danielkm-ee/EPL-Powercore-V3/CAD/PCV3-enclosure-revF.step

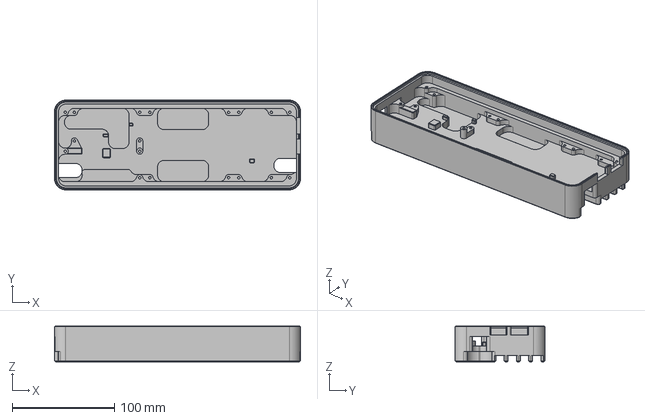
[picture p1: CAD file, 2025-09-30]
CAD/PCV3-enclosure-revF.step
241.0 x 88.0 x 35.0 mm
