danielkm-ee/EPL-Powercore-V3/CAD/PCV3-cover-panel-revF.step

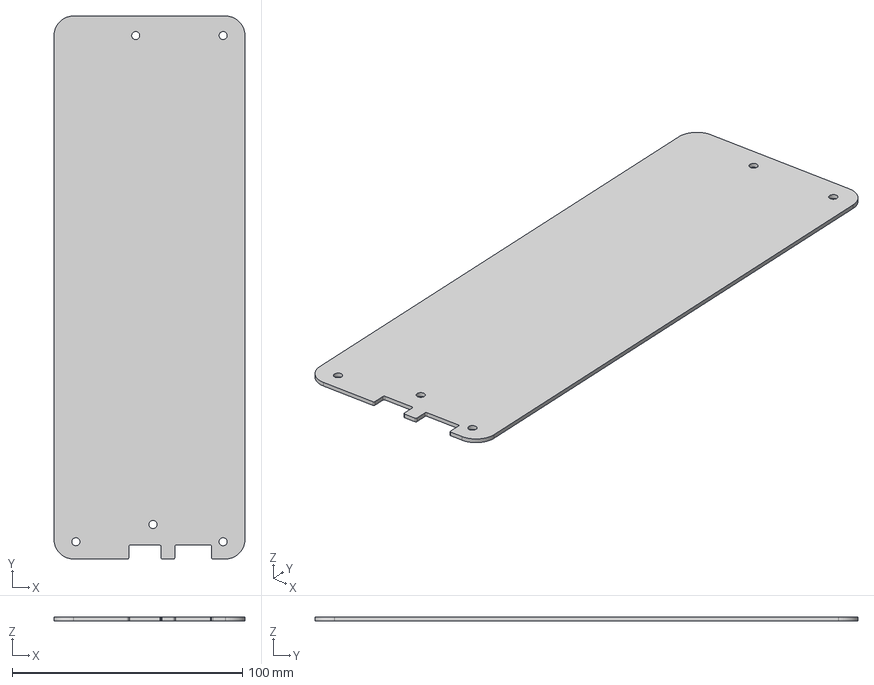
[picture p2: CAD file, 2025-09-30]
CAD/PCV3-cover-panel-revF.step
83.0 x 236.0 x 1.60 mm
