danielkm-ee/EPL-Powercore-V3/circuit-boards/dual-converter-boost-converter-module-V1.0/dual-converter-boost-converter-module-V1.0.kicad_pcb

## KiCad design circuit-boards/dual-converter-boost-converter-module-V1.0/dual-converter-boost-converter-module-V1.0.kicad_pcb (2026-02-24)

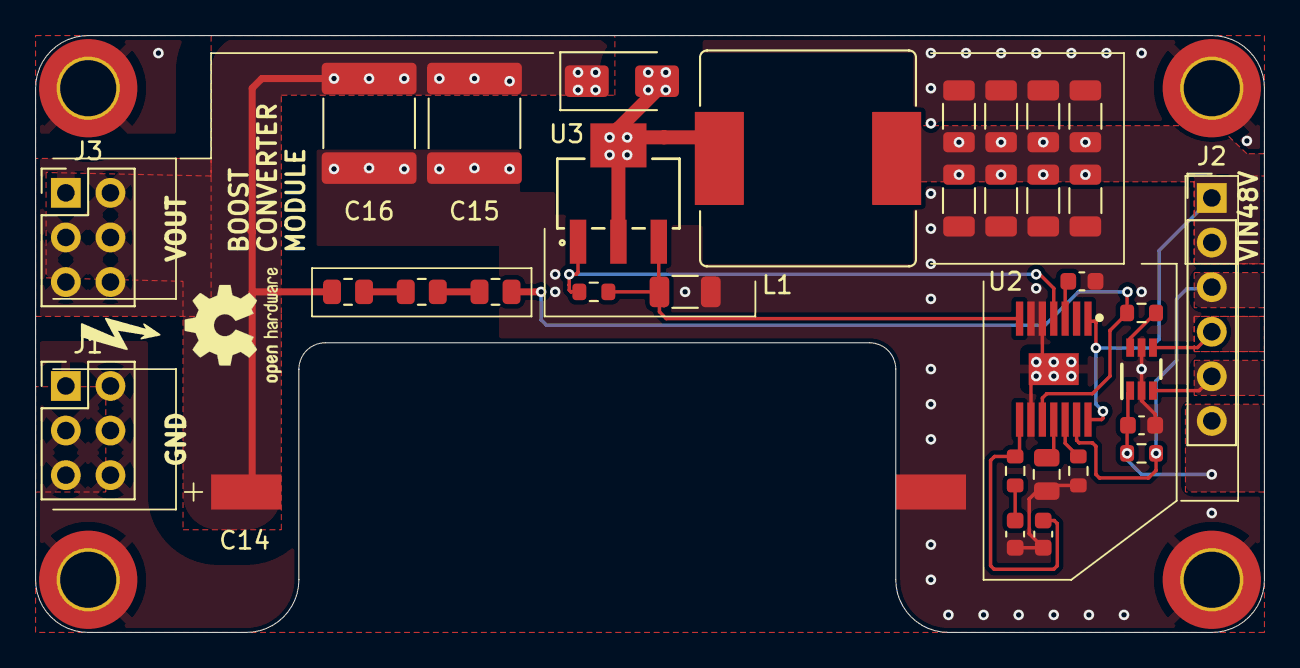
[picture p5: board dual-converter-boost-converter-module-V1.0.kicad_pcb from above]

Board: 4 copper layers, 70.0 x 34.0 mm, 37 parts (0 on the bottom side), 19 nets.

Parts:
C1, C2, C3, C4, C6, C7, C8, C9: 10 uF; C_1206_3216Metric
C5, C10: 1 uF; C_0603_1608Metric
C11: 33 uF; C_0805_2012Metric
C12: 39nF; C_0603_1608Metric
C13: F; C_0603_1608Metric
C14: 22UF; 226TTA350M
C15, C16: 2.2 uF; C_2220_5750Metric
D1: US1M-13-F; D_SMA
H1, H2, H3, H4: M3_DIN; MountingHole_3.2mm_M3_DIN965_Pad_TopBottom
J1, J3: Vout Conn; PinHeader_2x03_P2.54mm_Vertical
J2: Conn_01x06; PinHeader_1x06_P2.54mm_Vertical
L1: 680 uH; SRR1210-681M
R1, R2, R3: 200K; R_0805_2012Metric
R4, R5: 2.2K; R_0603_1608Metric
R6: 49.3K; R_0603_1608Metric
R7: 15K; R_0603_1608Metric
R8: 100K; R_0603_1608Metric
R9: 90mR; R_1206_3216Metric
U1: TPL0401B-10DCKR
U2: LM5156HPWPR; lm5156h
U3: STN3N40K3

Connections:
+3.3V: C5.1, J2.6, R5.1, U1.1 (VDD)
+48V: C1.1, C2.1, C3.1, C4.1, C6.1, C7.1, C8.1, C9.1, J2.1, J2.2, L1.1, U2.1 (BIAS), U2.14 (EN_UVLO_SYNC)
/BOOST_PGOOD: J2.3, R5.2, U2.13 (PGOOD)
/BOOST_SWITCH_NET: D1.2 (A), L1.2, U3.2 (D), U3.4 (D)
/COMPENSATION: C13.1, R7.1, U2.8 (COMP)
/COUT_BOOST: C14.1, C15.1, C16.1, D1.1 (K), J3.1, J3.2, J3.3, J3.4, J3.5, J3.6, R1.1
/CURRENT_SENSE: R8.2, R9.1, U2.7 (CS), U3.3 (S)
/GATE_NET: R8.1, U2.4 (GATE), U3.1 (G)
/V_FEEDBACK: R3.2, R4.2, U2.10 (FB)
GND: C1.2, C2.2, C3.2, C4.2, C5.2, C6.2, C7.2, C8.2, C9.2, C10.2, C11.2, C12.2, C13.2, C14.2, C15.2, C16.2, H1.1, H2.1, H3.1, H4.1, J1.1, J1.2, J1.3, J1.4, J1.5, J1.6, R6.2, R9.2, U1.2 (GND), U1.5 (W), U2.5 (PGND), U2.6 (AGND), U2.9 (DITHOFF), U2.15 (EP)
unnamed: C12.1, R7.2
unnamed: J2.4, U1.4 (SDA)
unnamed: J2.5, U1.3 (SCL)
unnamed: R1.2, R2.1
unnamed: R2.2, R3.1
unnamed: R4.1, U1.6 (H)
unnamed: R6.1, U2.12 (RT)
unnamed: C11.1, U2.11 (SS)
unnamed: C10.1, U2.3 (VCC)
