danielkm-ee/EPL-Powercore-V3/circuit-boards/dual-converter-pi-filter-module-V1.0/dual-converter-pi-filter-module-V1.0.kicad_pcb

## KiCad design circuit-boards/dual-converter-pi-filter-module-V1.0/dual-converter-pi-filter-module-V1.0.kicad_pcb (2026-02-24)

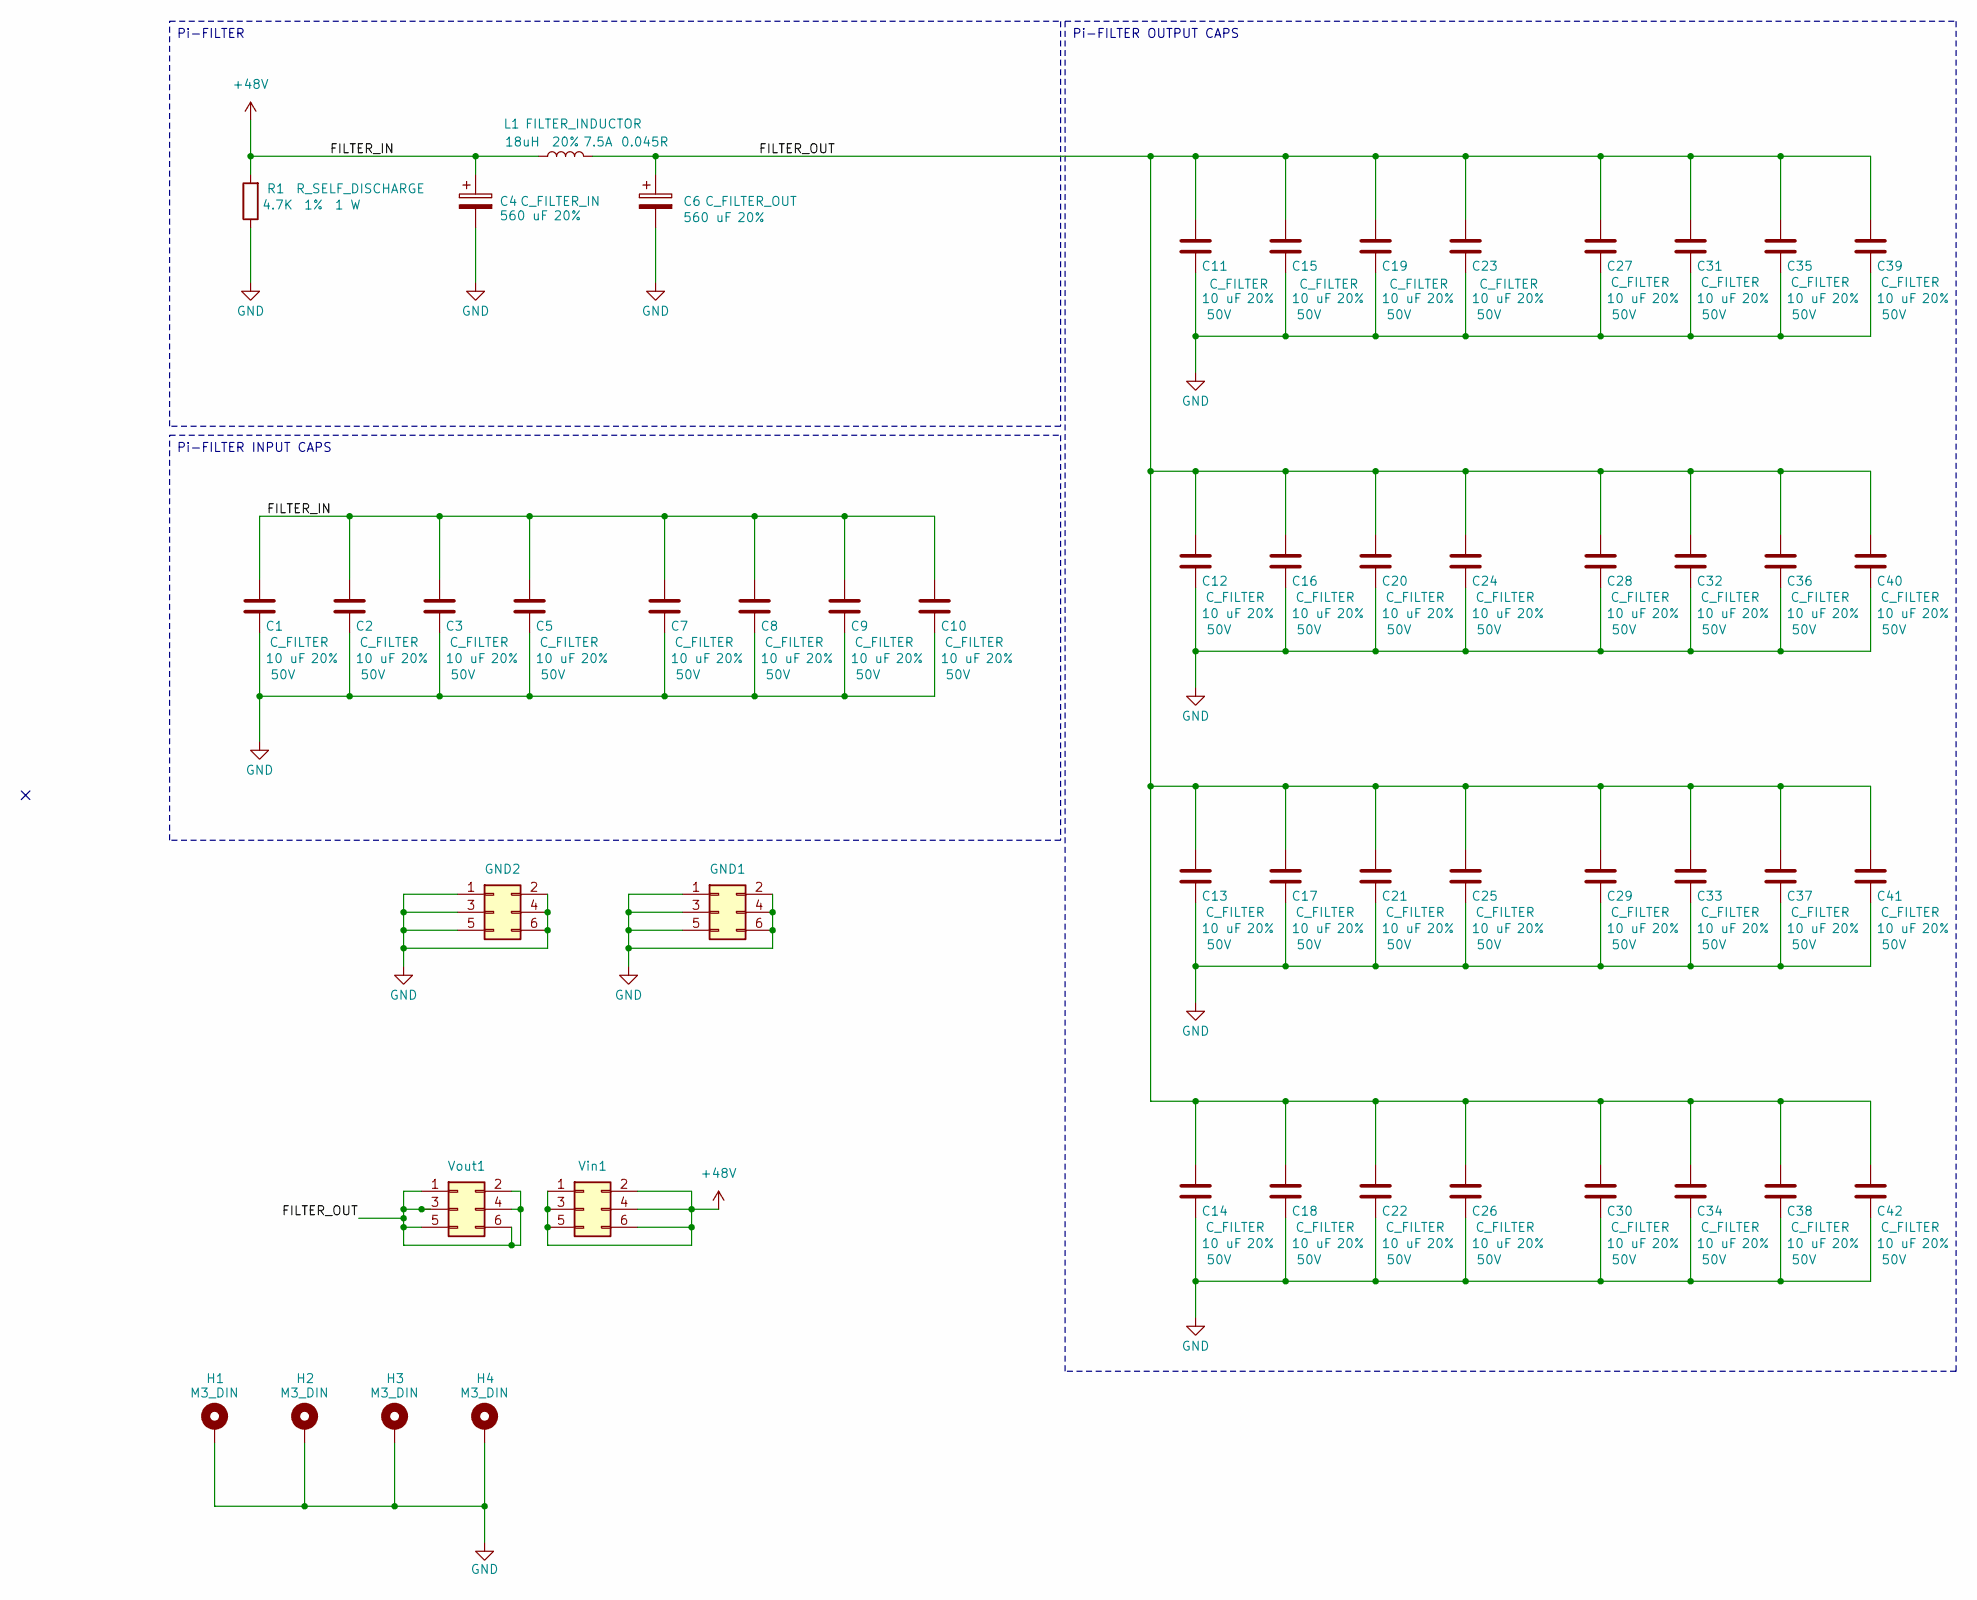
[picture p6: schematic dual-converter-pi-filter-module-V1.0.kicad_sch, dual-converter-pi-filter-module]

Parts:
C1, C2, C3, C5, C7, C8, C9, C10, C11, C12, C13, C14, C15, C16, C17, C18, C19, C20, C21, C22, C23, C24, C25, C26, C27, C28, C29, C30, C31, C32, C33, C34, C35, C36, C37, C38, C39, C40, C41, C42: 10 uF; C_1206_3216Metric; Tolerance 20%; Max Voltage 50V; Manufacturer# CL31A106MBHNNNE; LCSC Part # C96600
C4, C6: 560 uF; PHA225; Tolerance 20%; Manufacturer# PHA225MLP3560QE4; LCSC Part # C3274794
GND1, GND2: Conn_02x03_Odd_Even; PinHeader_2x03_P2.54mm_Vertical
H1, H2, H3, H4: M3_DIN; MountingHole_3.2mm_M3_DIN965_Pad_TopBottom; Manufacturer# NULL
L1: 18uH; SRP1245A; Tolerance 20%; Current Rating 7.5A; Manufacturer# SRP1245A-180M; LCSC Part # C5926042
R1: 4.7K; R_2512_6332Metric; Tolerance 1%; Manufacturer# RC2512JK-074K7L; LCSC Part # C878291
Vin1: Conn_02x03_Odd_Even; PinHeader_2x03_P2.54mm_Vertical
Vout1: Conn_02x03_Odd_Even; PinHeader_2x03_P2.54mm_Vertical

Connections:
+48V: C1.1, C2.1, C3.1, C4.1, C5.1, C7.1, C8.1, C9.1, C10.1, L1.1, R1.2, Vin1.1, Vin1.2, Vin1.3, Vin1.4, Vin1.5, Vin1.6
/FILTER_OUT: C6.1, C11.1, C12.1, C13.1, C14.1, C15.1, C16.1, C17.1, C18.1, C19.1, C20.1, C21.1, C22.1, C23.1, C24.1, C25.1, C26.1, C27.1, C28.1, C29.1, C30.1, C31.1, C32.1, C33.1, C34.1, C35.1, C36.1, C37.1, C38.1, C39.1, C40.1, C41.1, C42.1, L1.2, Vout1.1, Vout1.2, Vout1.3, Vout1.4, Vout1.5, Vout1.6
GND: C1.2, C2.2, C3.2, C4.2, C5.2, C6.2, C7.2, C8.2, C9.2, C10.2, C11.2, C12.2, C13.2, C14.2, C15.2, C16.2, C17.2, C18.2, C19.2, C20.2, C21.2, C22.2, C23.2, C24.2, C25.2, C26.2, C27.2, C28.2, C29.2, C30.2, C31.2, C32.2, C33.2, C34.2, C35.2, C36.2, C37.2, C38.2, C39.2, C40.2, C41.2, C42.2, GND1.1, GND1.2, GND1.3, GND1.4, GND1.5, GND1.6, GND2.1, GND2.2, GND2.3, GND2.4, GND2.5, GND2.6, H1.1, H2.1, H3.1, H4.1, R1.1

Notes on the sheet:
Pi-FILTER INPUT CAPS
Pi-FILTER
Pi-FILTER OUTPUT CAPS

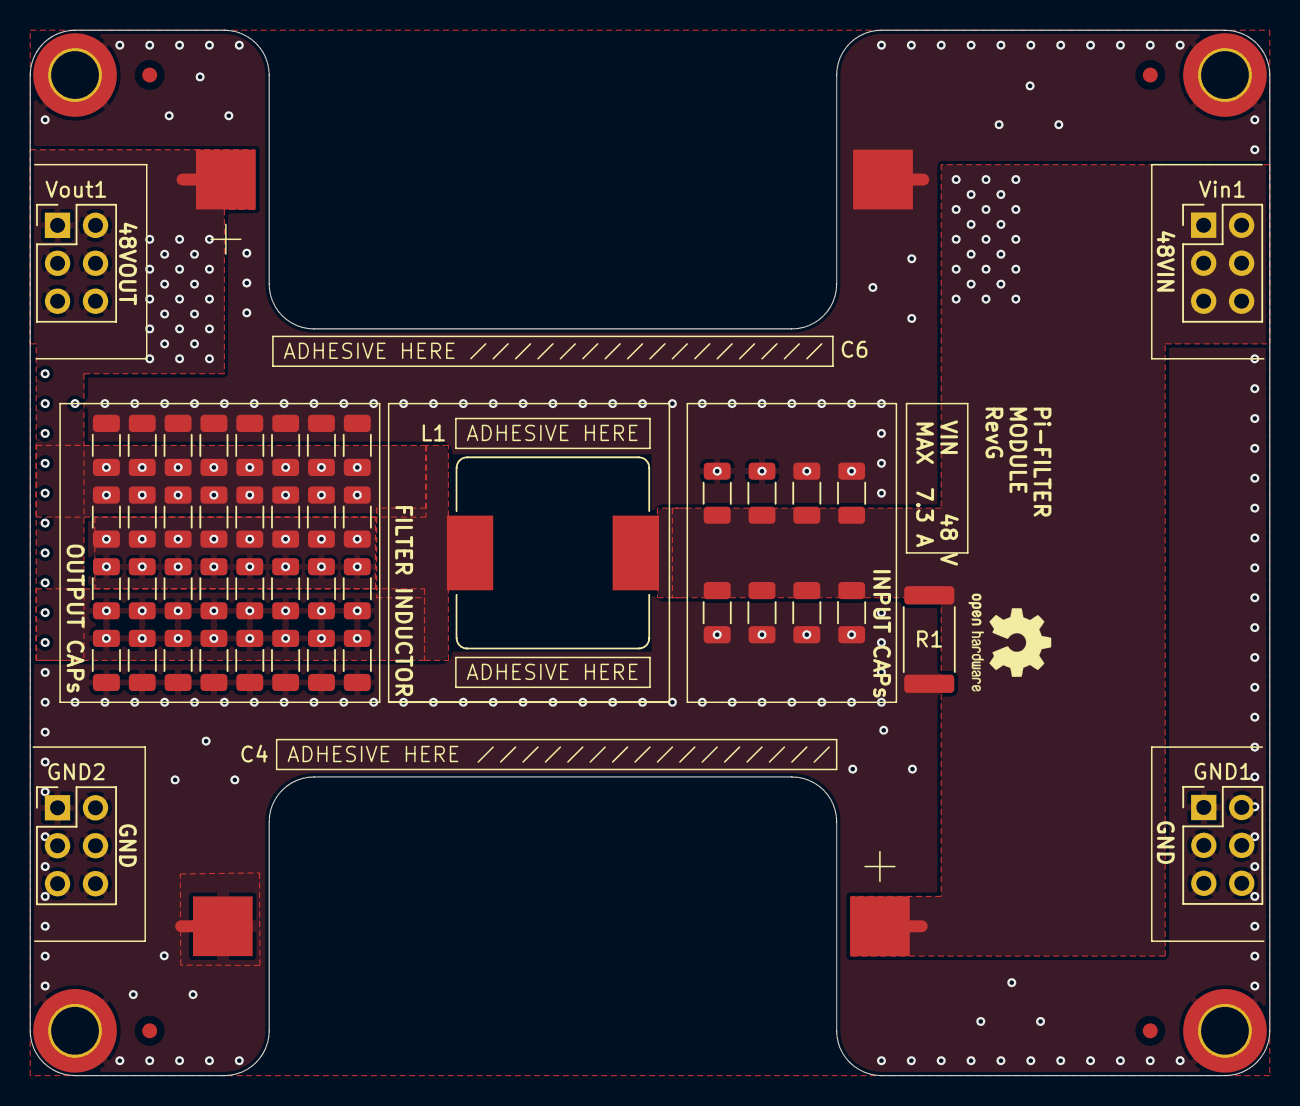
[picture p7: board dual-converter-pi-filter-module-V1.0.kicad_pcb from above]

Board: 4 copper layers, 83.0 x 70.0 mm, 52 parts (0 on the bottom side), 3 nets.
