danielkm-ee/EPL-Powercore-V3/circuit-boards/dual-converter-power-management-module-V1.0/dual-converter-power-management-module-V1.0.kicad_pcb

## KiCad design circuit-boards/dual-converter-power-management-module-V1.0/dual-converter-power-management-module-V1.0.kicad_pcb (2026-02-24)

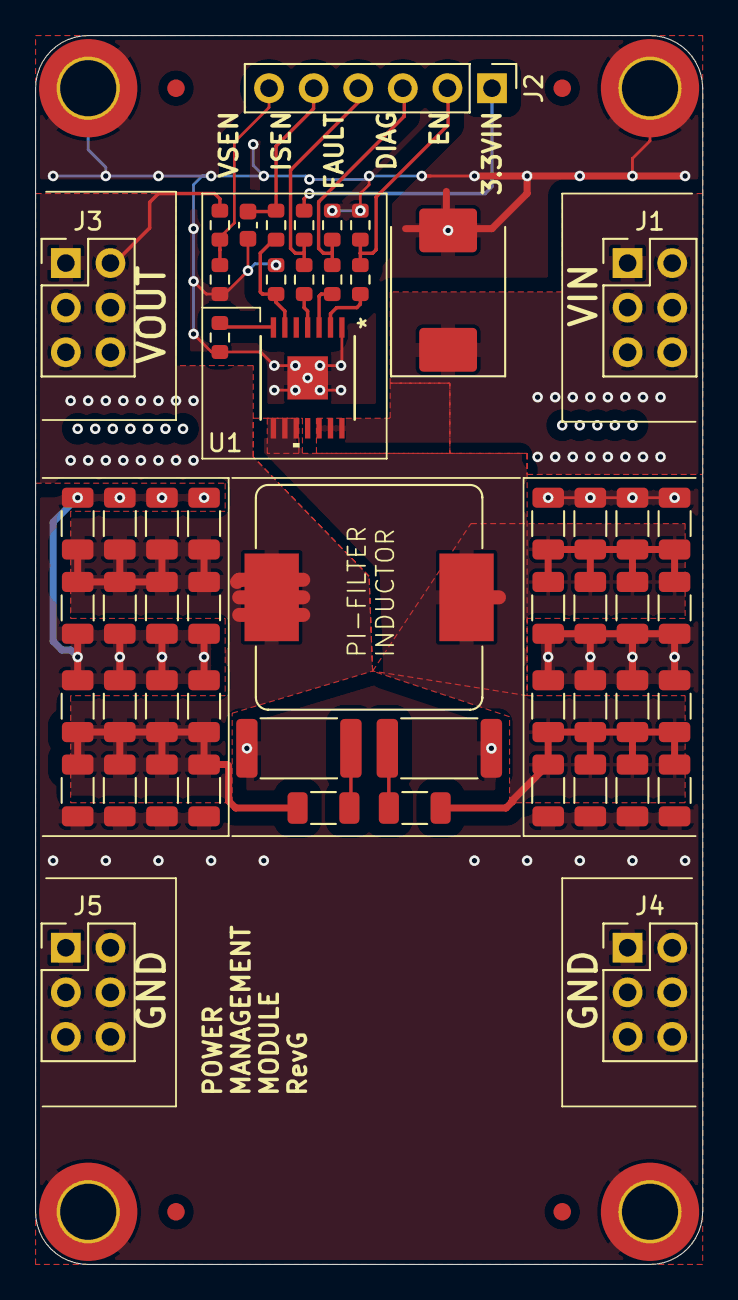
[picture p8: board dual-converter-power-management-module-V1.0.kicad_pcb from above]

Board: 4 copper layers, 38.0 x 70.0 mm, 60 parts (0 on the bottom side), 17 nets.

Parts:
C1: 1 uF; C_0603_1608Metric
C2, C3, C4, C5, C6, C7, C8, C9, C10, C11, C12, C13, C14, C15, C16, C17, C18, C19, C20, C21, C22, C23, C24, C25, C26, C27, C28, C29, C30, C31, C32, C33, C34, C35: 10 uF; C_1206_3216Metric
D1: SMCJ60A-E3/57T; D_SMC
H1, H2, H3, H4: M3_DIN; MountingHole_3.2mm_M3_DIN965_Pad_TopBottom
J1, J3, J4, J5: Conn_02x03_Odd_Even; PinHeader_2x03_P2.54mm_Vertical
J2: Conn_01x06_Pin; PinHeader_1x06_P2.54mm_Vertical
L1: 18uH; SRP1245A
R1, R6, R7: 100K; R_0603_1608Metric
R2, R3, R4, R5: 2.2K; R_0603_1608Metric
R8: 249R; R_0603_1608Metric
R9: 0R; R_0603_1608Metric
R10, R13: 1R; R_2512_6332Metric
R11: 172K; R_0603_1608Metric
R12: 10K; R_0603_1608Metric
U1: TPS1HTC30AQPWPRQ1; TPS1HTC30-Q1

Connections:
+3.3V: J2.1, R1.1
+48V: C19.1, C20.1, C21.1, C22.1, C23.1, C24.1, C25.1, C26.1, C27.1, C28.1, C29.1, C30.1, C31.1, C32.1, C33.1, C34.1, C35.1, J3.1, J3.2, J3.3, J3.4, J3.5, J3.6, L1.2, R11.1
+48VIN: D1.1 (A1), J1.1, J1.2, J1.3, J1.4, J1.5, J1.6, U1.12 (VS), U1.13 (VS), U1.14 (VS)
/FILTER_IN: C2.1, C3.1, C4.1, C5.1, C6.1, C7.1, C8.1, C9.1, C10.1, C11.1, C12.1, C13.1, C14.1, C15.1, C16.1, C17.1, C18.1, L1.1, U1.8 (VOUT), U1.9 (VOUT), U1.10 (VOUT)
GND: C1.2, C2.2, C3.2, C4.2, C5.2, C6.2, C7.2, C8.2, C9.2, C11.2, C12.2, C13.2, C14.2, C15.2, C16.2, C17.2, C18.2, C19.2, C20.2, C21.2, C22.2, C23.2, C24.2, C25.2, C26.2, C28.2, C29.2, C30.2, C31.2, C32.2, C33.2, C34.2, C35.2, D1.2 (A2), H1.1, H2.1, H3.1, H4.1, J4.1, J4.2, J4.3, J4.4, J4.5, J4.6, J5.1, J5.2, J5.3, J5.4, J5.5, J5.6, R6.2, R7.2, R8.2, R9.2, R10.2, R12.2, R13.2, U1.1 (GND)
unnamed: C10.2, R10.1
unnamed: C27.2, R13.1
unnamed: J2.2, R2.1, R6.1
unnamed: J2.3, R3.1, R7.1
unnamed: J2.4, R1.2, R4.1
unnamed: C1.1, J2.5, R5.1
unnamed: R4.2, U1.4 (*FAULT)
unnamed: R3.2, U1.3 (DIAG_EN)
unnamed: R2.2, U1.2 (EN)
unnamed: R9.1, U1.7 (ILIM)
unnamed: R5.2, R8.1, U1.6 (SNS)
VSense: J2.6, R11.2, R12.1
