danielkm-ee/EPL-Powercore-V3/(commit log)

2025-09-24 RevH Motherboard
    - removed unused vias from HVP switch
    = removed unused fiducials
    - silkscreen minor fixes to labels
    [designators.csv, dual-converter-motherboard-V1.0.kicad_pcb, dual-converter-motherboard-V1.0.kicad_sch]
2025-09-30 Added CAD to Powercore V3
    Upon request from customers
    [PCV3-cover-panel-revF.step, PCV3-enclosure-revF.step]
2026-02-14 replaced thermal reliefs with solid fills on high power traces
    [dual-converter-boost-converter-module-V1.0.kicad_pcb]
2026-02-18 begin replacing pogo pins with pin headers. todo: fix ugly schematic, add non power connections
    [dual-converter-motherboard-V1.0.kicad_pcb, dual-converter-motherboard-V1.0.kicad_sch]
2026-02-22 Replaced Pogo pins for pin headers, zone changes, deletion of vias and pads
    [dual-converter-boost-converter-module-V1.0.kicad_pcb, dual-converter-boost-converter-module-V1.0.kicad_sch]
2026-02-22 Replaced pogo pins with pin headers
    [dual-converter-power-management-module-V1.0.kicad_pcb, dual-converter-power-management-module-V1.0.kicad_sch]
2026-02-22 Deleted castellated edges and put in 2 by 3 pin header connectors, made all fillings solid
    [dual-converter-pi-filter-module-V1.0.kicad_pcb, dual-converter-pi-filter-module-V1.0.kicad_sch]
2026-02-23 add connectors for non-power pins, improve schematic readability
    [dual-converter-motherboard-V1.0.kicad_sch]
2026-02-23 add signal connector sockets, fix routing, rough-out locations
    [dual-converter-motherboard-V1.0.kicad_pcb]
2026-02-23 fix corrupted pcb after merge issues
    [dual-converter-boost-converter-module-V1.0.kicad_pcb]
2026-02-24 align and lock connectors and mountpoints. improve track sizing and layout
    [dual-converter-boost-converter-module-V1.0.kicad_pcb]
2026-02-24 motherboard: align and lock connectors and mountpoints, add cutout for pico test points, fix pico footprint, improve tracks
    [dual-converter-motherboard-V1.0.kicad_pcb]
2026-02-24 powerman: align and lock connectors and mountpoints, increase clearance and spacing on high voltage traces
    [dual-converter-power-management-module-V1.0.kicad_pcb]
2026-02-24 pifilter: align and lock connectors and mountpoints
    [dual-converter-pi-filter-module-V1.0.kicad_pcb]
2026-02-24 final drc checks, silkscreen edits, added stitching vias to motherboard and pi filter
    [dual-converter-boost-converter-module-V1.0.kicad_pcb, dual-converter-motherboard-V1.0.kicad_pcb, dual-converter-pi-filter-module-V1.0.kicad_pcb, dual-converter-power-management-module-V1.0.kicad_pcb]
2026-02-25 fix edgecut interference with trace
    [dual-converter-motherboard-V1.0.kicad_pcb]
